rosco-m68k/hardware-projects/mc68681-duart/README.md

# 68681 Dual UART board for rosco_m68k

This directory contains both the XR68C681 DUART board.
