rosco-m68k/hardware-projects/ioread-poc/arduino-ioread/README.md

# Arduino code for IO device demo

See `../README.md` for details
