rosco-m68k/hardware-projects/video9958/code/software/testimage/board.png

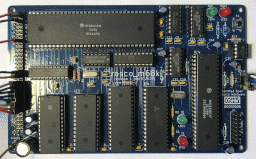
video9958/code/software/testimage/board.png
