rosco-m68k/hardware-projects/video9958/code/software/testimage/boardrender.png

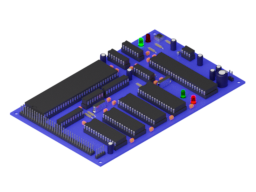
video9958/code/software/testimage/boardrender.png
