rosco-m68k/hardware-projects/(threads)

Thread 7 (2020-05-23):

Bus board mounting holes are the wrong size

roscopeco, 2020-05-23:
The mounting holes on the bus board are the wrong size (M2.5).They should be the same size as the mounting holes on the main board (M3).

The correct footprint for the bus board mounting holes is `MountingHole:MountingHole_3.2mm_M3`.

Closed 2020-05-23.

Thread 8 (2020-05-23):

Screw terminal polarity silkscreen is reversed

roscopeco, 2020-05-23:
The silkscreen indicating polarity of the screw terminals is incorrect and needs to be fixed as a priority.

The polarity is simply reversed.

Closed 2020-05-23.

Thread 18 (2020-07-23):

Pin 14 of the V9958 glue IC needs connecting to DTACK (with a jumper to support r1 boards)

roscopeco, 2020-07-23:
DTACK handling is corrected in r1.2 boards, this now needs to be supported by the V9958 card.

The GAL already does the appropriate thing, but on first revision boards the pin is not connected (an interim jumper wire fix has been issued to the community).

Going forward, this pin needs to be connected. It should run through a jumper to allow the functionality to be disabled when working with an r1 board (driving DTACK on that board will cause excessive current draw and potential incorrect operation).

roscopeco, 2020-08-29:
Fixed on r1.2 (now current).

Closed 2020-08-29.

Thread 26 (2020-09-02):

Use triangular footprint for transistors

roscopeco, 2020-09-02:
The transistors on the various boards (RAM and V9958) should use a triangular footprint, rather than the current in-line footprint which is optimised for automated PnP rather than hand assembly.

(Thanks to Watchmaker for pointing this issue out on Discord)

Thread 45 (2021-07-17):

V9958 Missing Characters on Console

roscopeco, 2021-07-17:
The standard V9958 console in the firmware (reported with both 1.2 and 1.3) occasionally misses characters when printing. This has been reported both as a standalone problem and with other issues (e.g. inability to load software via Kermit of SD card).

A recent occurrence of this issue looked as follows:

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

My current working hypothesis is that we have a race condition somewhere in the console's `PUTCHAR` routine. However, I still cannot rule anything else, including possible hardware issues, out at this point.

Thread 54 (2022-03-16):

Improve "RGB Cut"-label in Xosera schematic

eibach, 2022-03-16:
In the Xosera schematic there is a ``RGB Jumper Cut`` label for the Upduino board. The Upduino silkscreen does not specify an ``RGB`` Jumper, but it is called ``R28``. So please change the label to ``RGB Jumper(R28) Cut``.

roscopeco, 2022-03-16:
Triage: accepted, will do. Thanks @eibach 👍

Thread 56 (2022-11-16):

26.5 lines mode, R#2 bit 7 weirdness

caiannello, 2022-11-16:
Hi,

This is a question rather than an issue. I wanted to try to use the 26.5 lines mode rather than the 24 lines mode, so I added #128 to DM_NTSC (in my case) to ensure bit 7 of R#2 gets set, and changed LINECOUNT from 24 to 26.

I end up with a screen which does indeed have 26.5 lines on it, but the content is all random characters from the chosen font, and I can't seem to be able to change its contents by loading new bytes into VDP text page 0 like I could in 24 line mode.

Do I need to relocate anything in the VRAM such as the pattern table or pattern name tables?  In my current implementation, I have my own VBLANK ISR and I don't even use page 1. I'm always only loading stuff into vdp text page 0. I don't think my problem could be caused by overlap with page 1 since I'm not even using it, but maybe I have to move the font pattern table?

Thanks,
Craig

caiannello, 2022-11-22:
It wasn't a VDP issue, it was a bug.

Closed 2022-11-22.
