rosco-m68k/hardware-projects/xosera/design/kicad/xosera.pdf

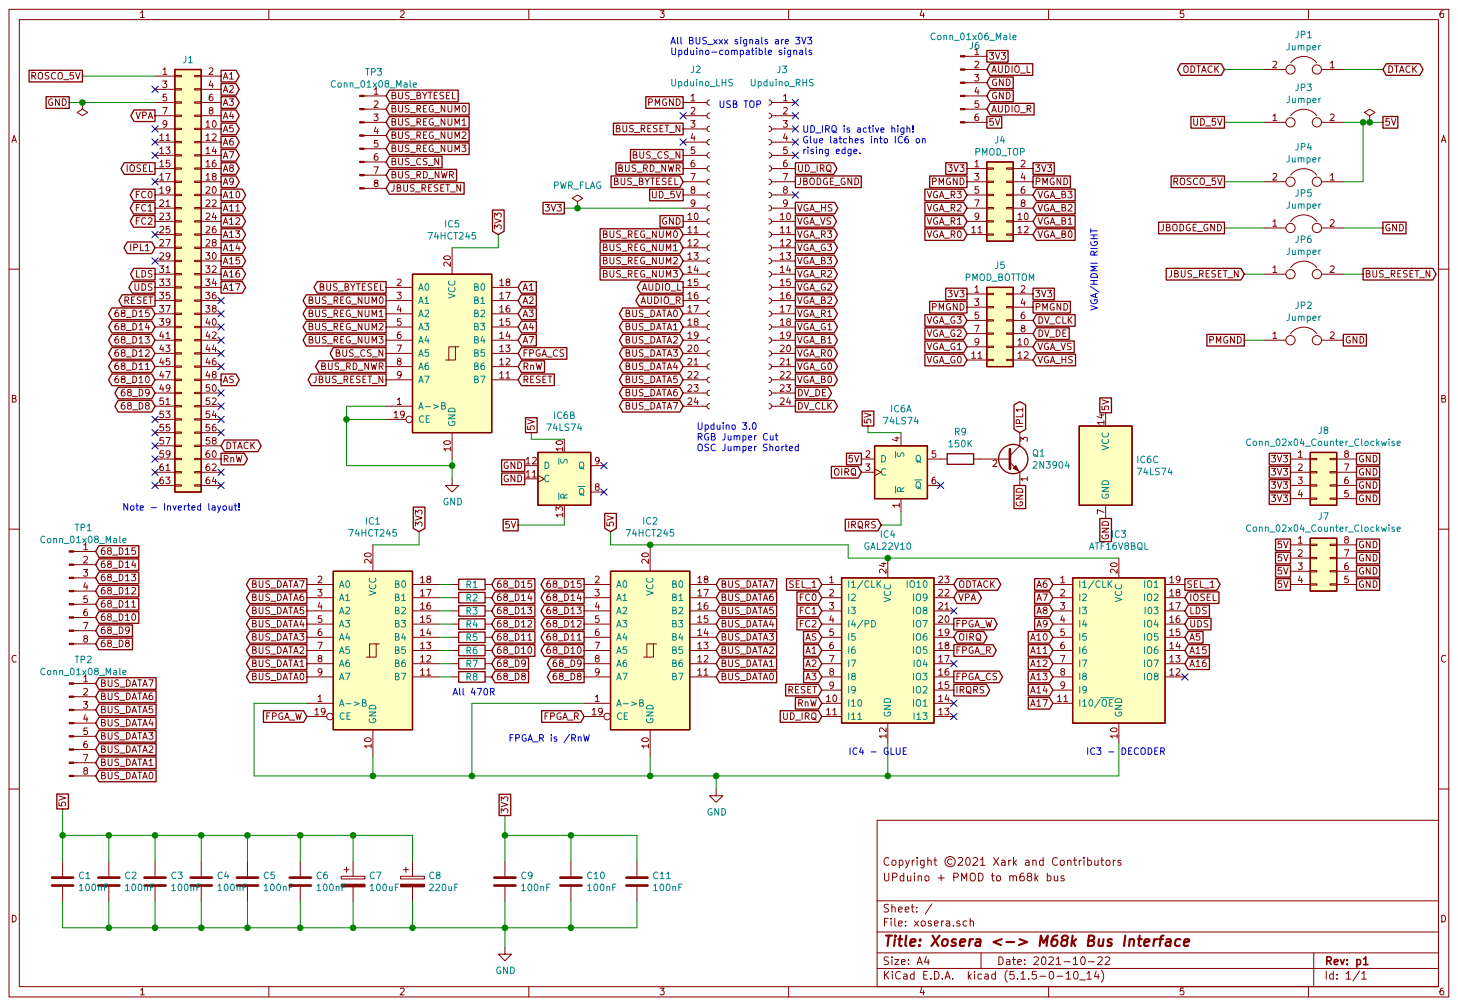
[picture p4: page 1]

File: xosera.sch Sheet: / UPduino + PMOD to m68k bus Copyright ©2021 Xark and Contributors

Id: 1/1 Title: Xosera <-> M68k Bus Interface
