rosco-m68k/hardware-projects/mc68681-duart/design/kicad/mc68681-basic/mc68681-basic.pdf

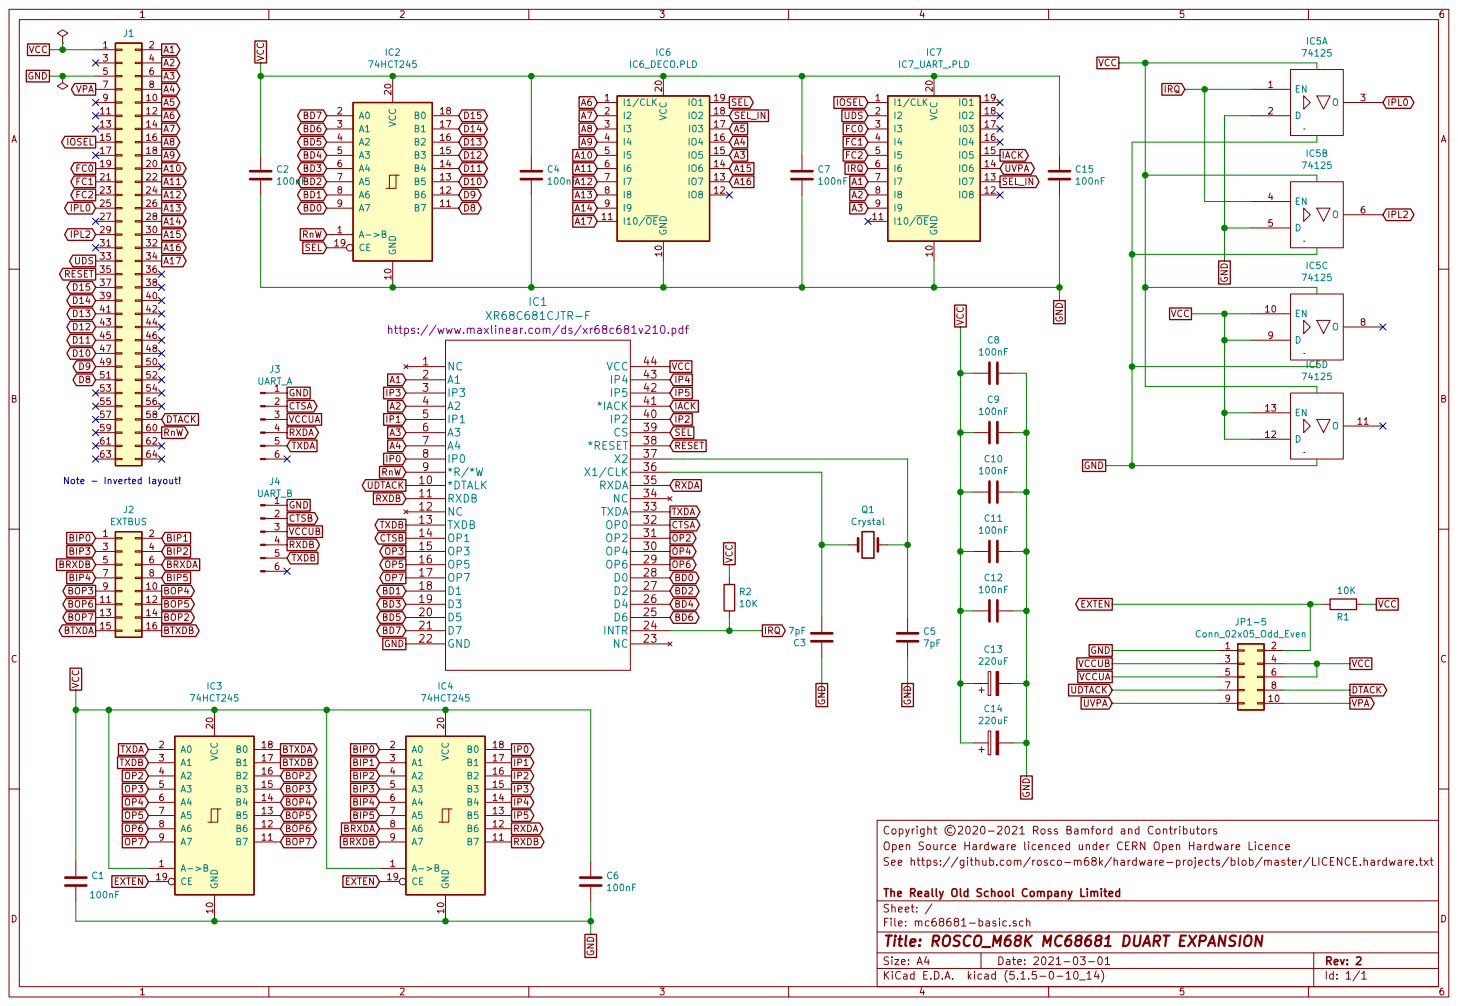
[picture p5: page 1]

TXDA Note - Inverted layout!

Copyright ©2020-2021 Ross Bamford and Contributors
Open Source Hardware licenced under CERN Open Hardware Licence
See https://github.com/rosco-m68k/hardware-projects/blob/master/LICENCE.hardware.txt

File: mc68681-basic.sch Sheet: / The Really Old School Company Limited

Id: 1/1 Title: ROSCO_M68K MC68681 DUART EXPANSION
