rosco-m68k/hardware-projects/flash-rom/design/kicad/flash-rom-expansion/flash-rom-expansion.pdf

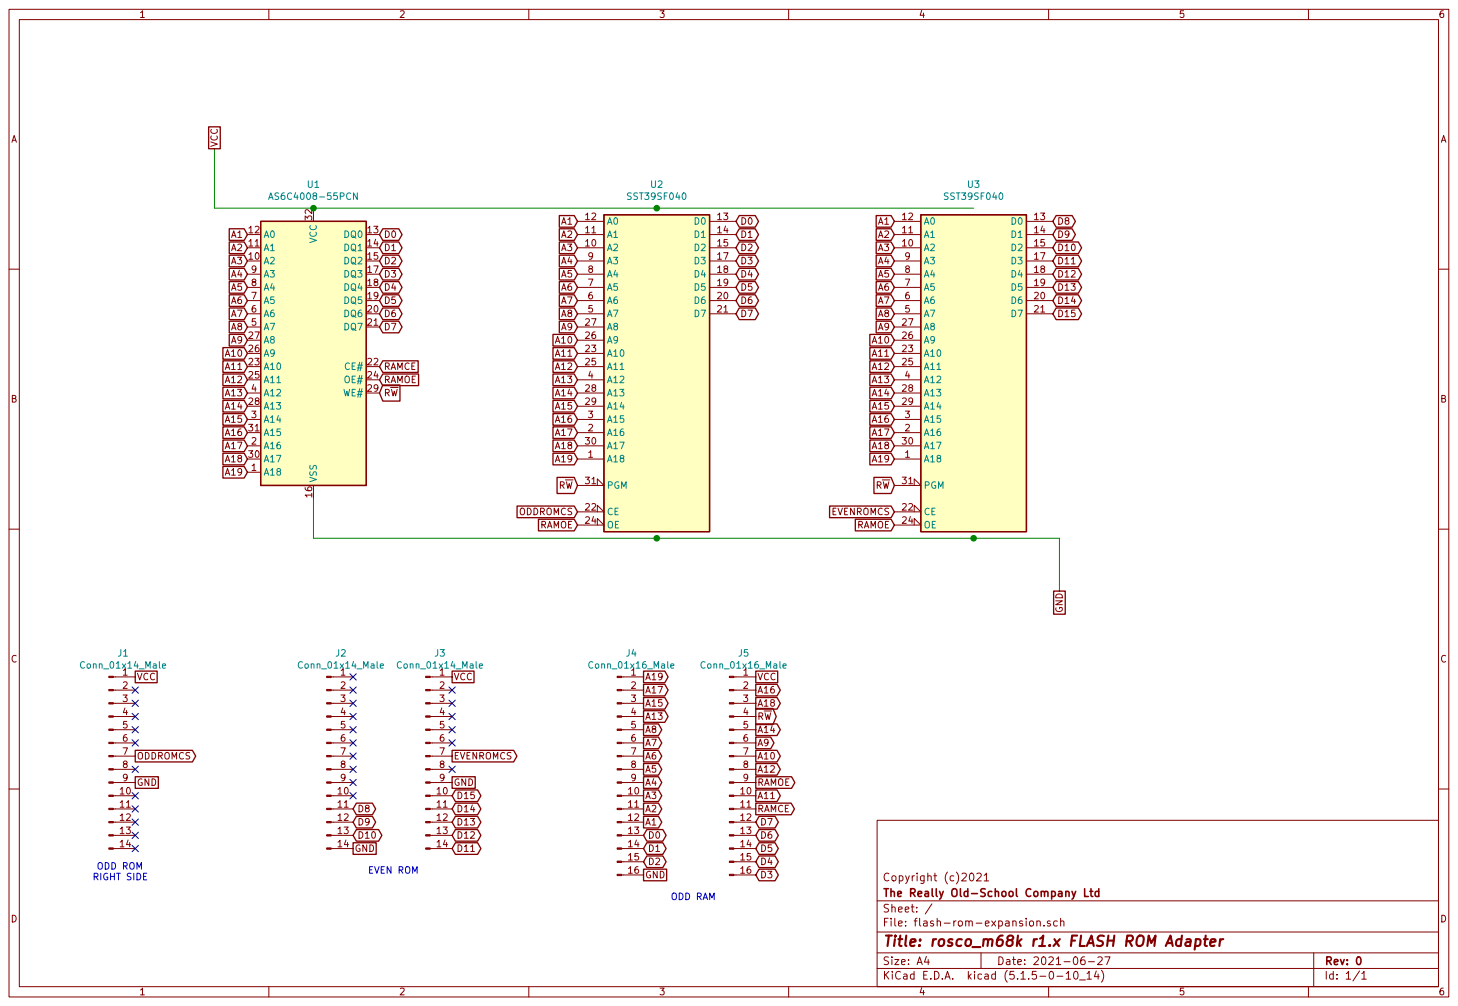
[picture p6: page 1]

EVEN ROM ODD ROM RIGHT SIDE

File: flash-rom-expansion.sch Sheet: / The Really Old-School Company Ltd

Id: 1/1 Title: rosco_m68k r1.x FLASH ROM Adapter
