rosco-m68k/hardware-projects/video9958/design/kicad/v9958video/v9958video.pdf

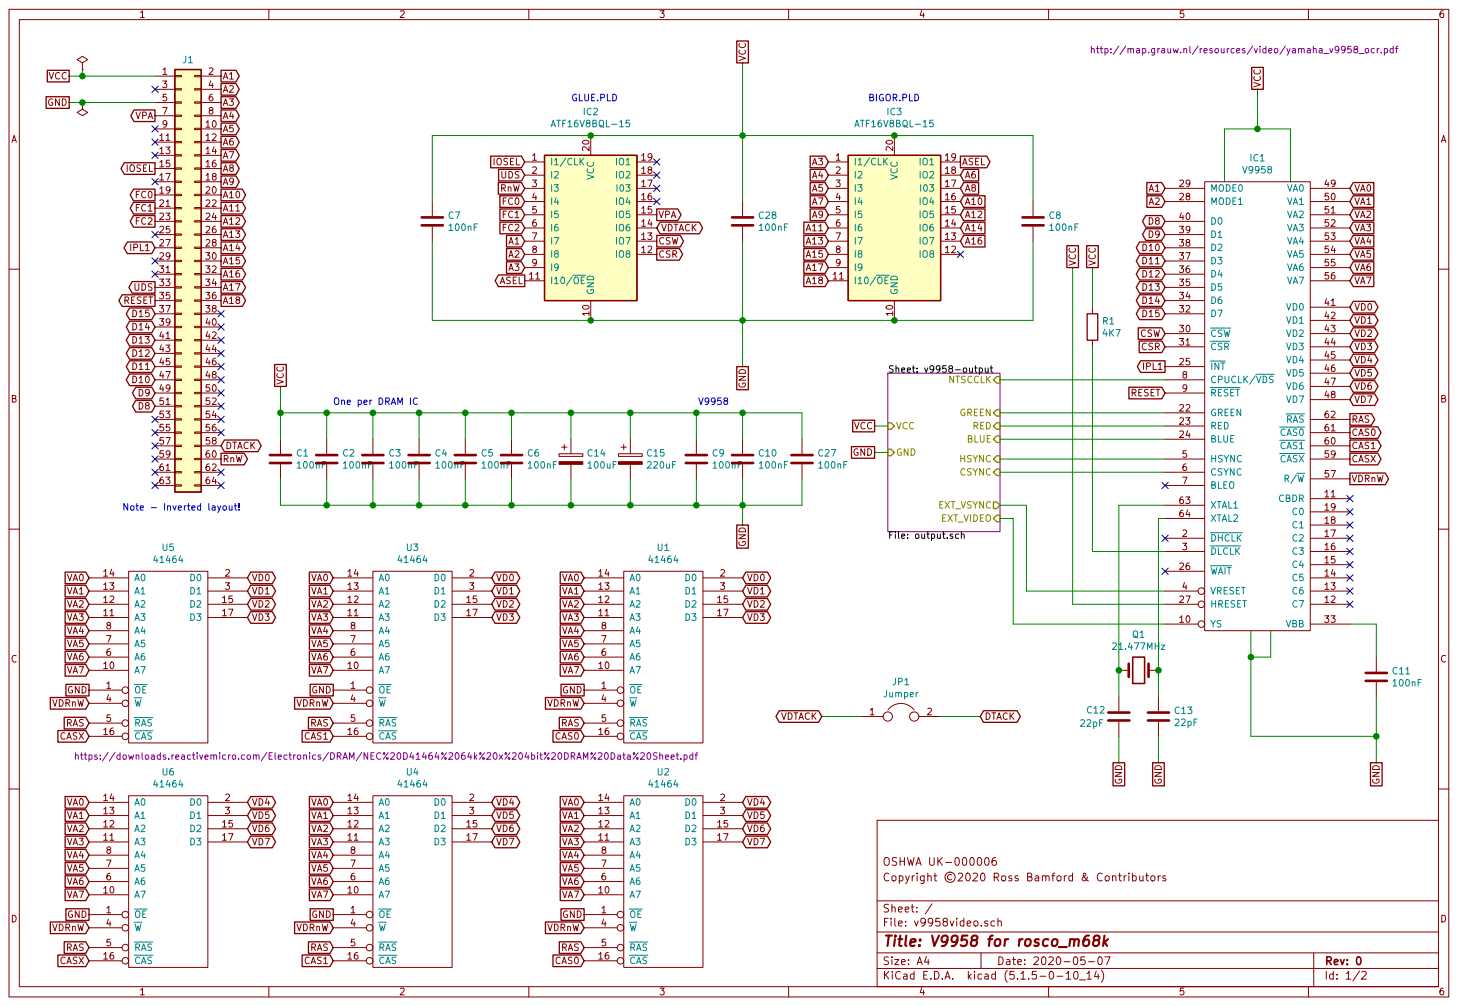
[picture p7: page 1]

File: v9958video.sch Sheet: / Copyright ©2020 Ross Bamford & Contributors OSHWA UK-000006

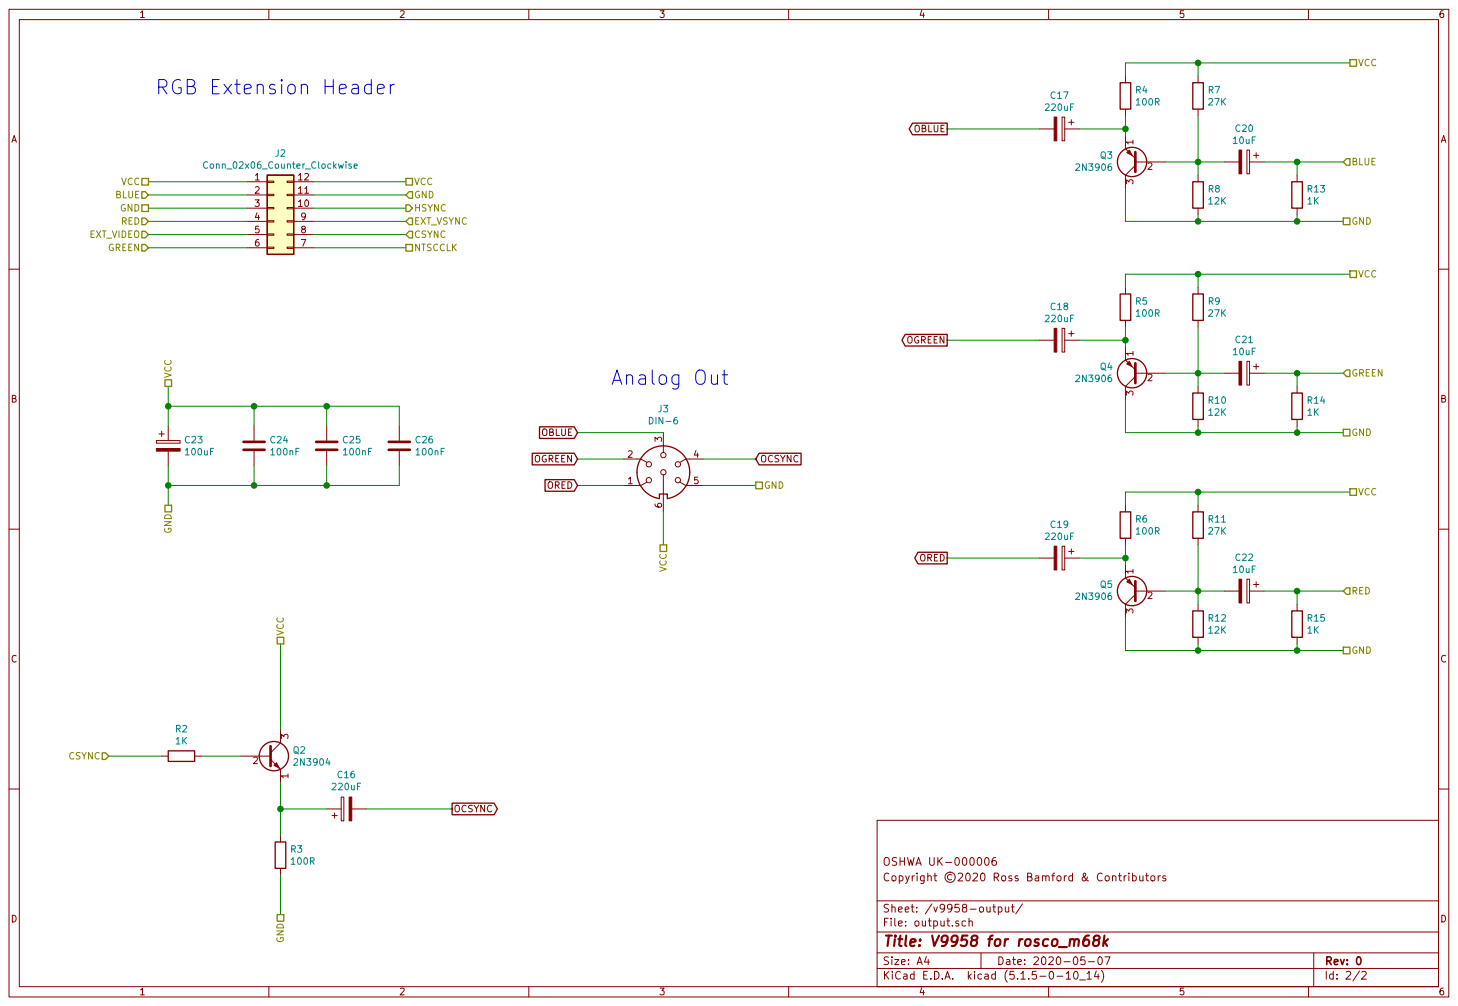
[picture p8: page 2]

Copyright ©2020 Ross Bamford & Contributors OSHWA UK-000006 C26
