rosco-m68k/hardware-projects/bus-board/design/kicad/r0/roscbus01/roscbus01.pdf

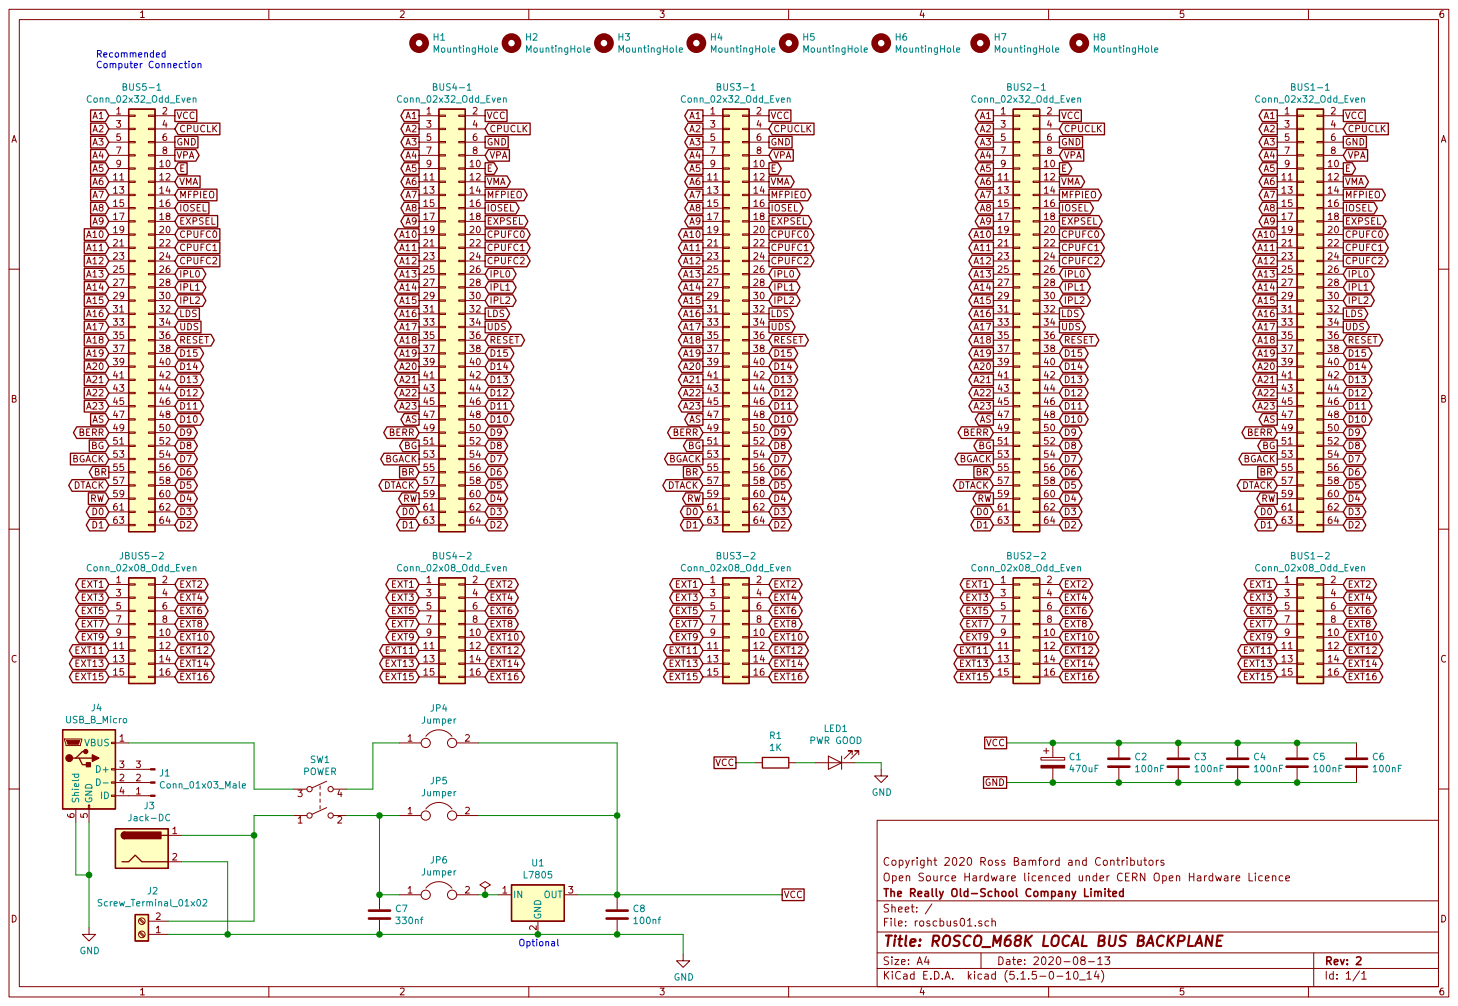
[picture p9: page 1]

Copyright 2020 Ross Bamford and Contributors
Open Source Hardware licenced under CERN Open Hardware Licence
File: roscbus01.sch Sheet: / The Really Old-School Company Limited

Id: 1/1 Title: ROSCO_M68K LOCAL BUS BACKPLANE
