rosco-m68k/hardware-projects/(list of files, drawings)

Other design files:
RAM-hat-4MB/Rosco_Hat_RAM.dsn
