rosco-m68k/hardware-projects/(commit log)

2020-04-13 Ignore kicad backups
2020-04-13 First cut od RAM expansion
    [roscram01.kicad_pcb, roscram01.sch]
2020-04-15 First cut for manufacturing
    [roscram01-B_Cu.gbr, roscram01-B_Mask.gbr, roscram01-B_Paste.gbr, roscram01-B_SilkS.gbr, roscram01-Edge_Cuts.gbr, roscram01-F_Cu.gbr, roscram01-F_Mask.gbr, roscram01-F_Paste.gbr]
2020-04-20 Add board image
2020-04-25 First cut bus board
    [roscbus01.kicad_pcb, roscbus01.sch]
2020-04-25 Updates and add CAM outputs
    [roscbus01-B_Cu.gbr, roscbus01-B_Mask.gbr, roscbus01-B_Paste.gbr, roscbus01-B_SilkS.gbr, roscbus01-Edge_Cuts.gbr, roscbus01-F_Cu.gbr, roscbus01-F_Mask.gbr, roscbus01-F_Paste.gbr]
2020-04-29 Fix incorrect size and clean up
    [roscram01-B_Cu.gbr, roscram01-B_Mask.gbr, roscram01-B_Paste.gbr, roscram01-B_SilkS.gbr, roscram01-Edge_Cuts.gbr, roscram01-F_Cu.gbr, roscram01-F_Mask.gbr, roscram01-F_Paste.gbr]
2020-05-07 Silkscreen fixes
    [roscbus01.kicad_pcb]
2020-05-08 Minor fixes
    [roscbus01-B_Cu.gbr, roscbus01-B_Mask.gbr, roscbus01-B_Paste.gbr, roscbus01-B_SilkS.gbr, roscbus01-Edge_Cuts.gbr, roscbus01-F_Cu.gbr, roscbus01-F_Mask.gbr, roscbus01-F_Paste.gbr]
2020-05-14 Add RAM expension BOM
    [roscram01.csv]
2020-05-14 First cut video board and supporting code
    [output.sch, v9958video.kicad_pcb, v9958video.sch]
2020-05-14 First cut PCB
    [output.sch, v9958video.kicad_pcb, v9958video.sch]
2020-05-23 First round fixes
    [output.sch, v9958video.kicad_pcb, v9958video.sch]
2020-05-23 Add BOM
    [roscbus01.csv, roscbus01.sch]
2020-05-23 Rev 1 - Four layer board
    [output.sch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]
2020-05-23 Add missed changes from CAM output
    [v9958video.kicad_pcb]
2020-05-23 Fix #8
    [roscbus01.kicad_pcb]
2020-05-23 Fix #7
    [roscbus01-B_Cu.gbr, roscbus01-B_Mask.gbr, roscbus01-B_Paste.gbr, roscbus01-B_SilkS.gbr, roscbus01-Edge_Cuts.gbr, roscbus01-F_Cu.gbr, roscbus01-F_Mask.gbr, roscbus01-F_Paste.gbr]
2020-06-03 Make IC numbering less nonsensical
    [v9958video.kicad_pcb, v9958video.sch]
2020-06-05 Revision 1.1 RTM
    [output.sch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]
2020-06-05 Final tweaks
    [v9958video-B_Cu.gbr, v9958video-B_Mask.gbr, v9958video-B_Paste.gbr, v9958video-B_SilkS.gbr, v9958video-Edge_Cuts.gbr, v9958video-F_Cu.gbr, v9958video-F_Mask.gbr, v9958video-F_Paste.gbr]
2020-06-07 Initial work
    [mc68681-basic.kicad_pcb, mc68681-basic.sch]
2020-06-12 r0 layout, PLD changes for same
    [mc68681-basic-B_Cu.gbr, mc68681-basic-B_Mask.gbr, mc68681-basic-B_Paste.gbr, mc68681-basic-B_SilkS.gbr, mc68681-basic-Edge_Cuts.gbr, mc68681-basic-F_Cu.gbr, mc68681-basic-F_Mask.gbr, mc68681-basic-F_Paste.gbr]
2020-06-12 List DUART board in README
2020-06-16 First-cut console
2020-06-25 Fix a couple of issues...
    [mc68681-basic-B_Cu.gbr, mc68681-basic-B_Mask.gbr, mc68681-basic-B_Paste.gbr, mc68681-basic-B_SilkS.gbr, mc68681-basic-Edge_Cuts.gbr, mc68681-basic-F_Cu.gbr, mc68681-basic-F_Mask.gbr, mc68681-basic-F_Paste.gbr]
2020-07-02 Final version RTM
    [mc68681-basic-B_Cu.gbr, mc68681-basic-B_Mask.gbr, mc68681-basic-B_Paste.gbr, mc68681-basic-B_SilkS.gbr, mc68681-basic-Edge_Cuts.gbr, mc68681-basic-F_Cu.gbr, mc68681-basic-F_Mask.gbr, mc68681-basic-F_Paste.gbr]
2020-07-20 Add first-cut memory map
2020-08-13 Bus revision 3
    [roscbus01-B_Cu.gbr, roscbus01-B_Mask.gbr, roscbus01-B_Paste.gbr, roscbus01-B_SilkS.gbr, roscbus01-Edge_Cuts.gbr, roscbus01-F_Cu.gbr, roscbus01-F_Mask.gbr, roscbus01-F_Paste.gbr]
2020-08-13 VDP r1.2
    [v9958video-B_Cu.gbr, v9958video-B_Mask.gbr, v9958video-B_Paste.gbr, v9958video-B_SilkS.gbr, v9958video-Edge_Cuts.gbr, v9958video-F_Cu.gbr, v9958video-F_Mask.gbr, v9958video-F_Paste.gbr]
2020-08-13 Add jumper to support 1.2 mainboard
    [v9958video-B_Cu.gbr, v9958video-B_Mask.gbr, v9958video-B_Paste.gbr, v9958video-B_SilkS.gbr, v9958video-Edge_Cuts.gbr, v9958video-F_Cu.gbr, v9958video-F_Mask.gbr, v9958video-F_Paste.gbr]
2020-08-13 Add missed change
    [v9958video.kicad_pcb]
2020-08-29 Fix incorrect direction for EXT drivers
    [mc68681-basic-B_Cu.gbr, mc68681-basic-B_Mask.gbr, mc68681-basic-B_Paste.gbr, mc68681-basic-B_SilkS.gbr, mc68681-basic-Edge_Cuts.gbr, mc68681-basic-F_Cu.gbr, mc68681-basic-F_Mask.gbr, mc68681-basic-F_Paste.gbr]
2020-09-16 Fixes for 1.2 mainboard
    [mc68681-basic-B_Cu.gbr, mc68681-basic-B_Mask.gbr, mc68681-basic-B_Paste.gbr, mc68681-basic-B_SilkS.gbr, mc68681-basic-Edge_Cuts.gbr, mc68681-basic-F_Cu.gbr, mc68681-basic-F_Mask.gbr, mc68681-basic-F_Paste.gbr]
2021-03-21 Claim IPL3 and 00F80040-00F8005F for my ATA/IDE board.
2021-03-21 Correct type of interrupt used by MC68681 cards.
2021-04-06 Add new XR68C681 board
    [mc68681-basic-B_Cu.gbr, mc68681-basic-B_Mask.gbr, mc68681-basic-B_Paste.gbr, mc68681-basic-B_SilkS.gbr, mc68681-basic-Edge_Cuts.gbr, mc68681-basic-F_Cu.gbr, mc68681-basic-F_Mask.gbr, mc68681-basic-F_Paste.gbr]
2021-06-26 Add 020/030 etc to libs
    [rosco_m68k_r1_020.csv]
2021-06-26 DUART 2.1
    [mc68681-basic-B_Cu.gbr, mc68681-basic-B_Mask.gbr, mc68681-basic-B_Paste.gbr, mc68681-basic-B_SilkS.gbr, mc68681-basic-Edge_Cuts.gbr, mc68681-basic-F_Cu.gbr, mc68681-basic-F_Mask.gbr, mc68681-basic-F_Paste.gbr]
2021-06-27 First cut flash ROM adapter
    [flash-rom-expansion-B_Cu.gbr, flash-rom-expansion-B_Mask.gbr, flash-rom-expansion-B_Paste.gbr, flash-rom-expansion-B_SilkS.gbr, flash-rom-expansion-Edge_Cuts.gbr, flash-rom-expansion-F_Cu.gbr, flash-rom-expansion-F_Mask.gbr, flash-rom-expansion-F_Paste.gbr]
2021-06-27 Fix unconnected A16 (thanks to JLCPCB for spotting)
    [flash-rom-expansion-B_Cu.gbr, flash-rom-expansion-B_Mask.gbr, flash-rom-expansion-B_Paste.gbr, flash-rom-expansion-B_SilkS.gbr, flash-rom-expansion-Edge_Cuts.gbr, flash-rom-expansion-F_Cu.gbr, flash-rom-expansion-F_Mask.gbr, flash-rom-expansion-F_Paste.gbr]
2021-07-07 Add initial Xosera design and GAL code
    [output.sch, xosera.kicad_pcb, xosera.sch]
2021-07-07 Update schematic for new glue and buffer
    [xosera.sch]
2021-07-07 Flesh out schematic, ERC pass and prep for layout
    [xosera.sch]
2021-07-07 Add extra GND jumper, audio, start PCB placement
    [xosera.kicad_pcb, xosera.sch]
2021-07-07 Move reset pin
    [xosera.sch]
2021-07-07 Rejig pins, fix names and change buffer pinouts
    [xosera.sch]
2021-07-07 Switch HDMI_CLK to DV_CLK
    [xosera.sch]
2021-07-07 Add testpoints and change net names a bit to match Xark's Verilog
    [xosera.sch]
2021-07-07 Also rename DVI_EN to DV_EN for consistency
    [xosera.sch]
2021-07-07 Switch DV_EN for DV_DE for 1BitSquared consistency
    [xosera.sch]
2021-07-07 First cut add software tests
2021-07-07 Layout PCB
    [xosera-B_Cu.gbr, xosera-B_Mask.gbr, xosera-B_Paste.gbr, xosera-B_SilkS.gbr, xosera-Edge_Cuts.gbr, xosera-F_Cu.gbr, xosera-F_Mask.gbr, xosera-F_Paste.gbr]
2021-07-07 First cut new GAL and IACK
    [xosera.kicad_pcb, xosera.sch]
2021-07-07 Proto r1
    * IRQ / IACK support
    * Fixed PMOD layout
    [xosera-B_Cu.gbr, xosera-B_Mask.gbr, xosera-B_Paste.gbr, xosera-B_SilkS.gbr, xosera-Edge_Cuts.gbr, xosera-F_Cu.gbr, xosera-F_Mask.gbr, xosera-F_Paste.gbr]
2021-07-07 Further fixes for r1
    * Add RESET jumper
    * Fix 7474 hookup
    [xosera-B_Cu.gbr, xosera-B_Mask.gbr, xosera-B_Paste.gbr, xosera-B_SilkS.gbr, xosera-Edge_Cuts.gbr, xosera-F_Cu.gbr, xosera-F_Mask.gbr, xosera-F_Paste.gbr]
2021-07-07 Add GPIO10 and 3V3 on audio header
    [xosera-B_Cu.gbr, xosera-B_Mask.gbr, xosera-B_Paste.gbr, xosera-B_SilkS.gbr, xosera-Edge_Cuts.gbr, xosera-F_Cu.gbr, xosera-F_Mask.gbr, xosera-F_Paste.gbr]
2021-07-11 Revert "DUART 2.1"
    This reverts commit 27795c8f7bdad45632c07cace90e5a666905ce82.
    [mc68681-basic-B_Cu.gbr, mc68681-basic-B_Mask.gbr, mc68681-basic-B_Paste.gbr, mc68681-basic-B_SilkS.gbr, mc68681-basic-Edge_Cuts.gbr, mc68681-basic-F_Cu.gbr, mc68681-basic-F_Mask.gbr, mc68681-basic-F_Paste.gbr]
2021-08-12 Fix IRQ reset / acknowledge glue
2021-08-12 Update IRQ test to print one asterisk per second
2021-08-13 Update for GPIO10 IRQ
    [xosera-B_Cu.gbr, xosera-B_Mask.gbr, xosera-B_Paste.gbr, xosera-B_SilkS.gbr, xosera-Edge_Cuts.gbr, xosera-F_Cu.gbr, xosera-F_Mask.gbr, xosera-F_Paste.gbr]
2021-08-15 Add automatic end-of-interrupt
    With this change, the glue logic will automatically clear the
    interrupt latch, meaning software will no longer need to do
    a Xosera read to clear it.
    In discussion on Discord this was felt to be more useful, and
    neatly sidesteps a few issues when a non-Xosera specific handler
    is registered (i.e. if level 2 interrupts are enabled without
    a handler other than the basic one provided by the firmware).
    It also makes races less likely when multiple interrupts overlap
    (e.g. another is raised while one is still in-service).
2021-08-15 Add missing footprints / update logo
2021-08-15 Preparing for production...
    [xosera-B_Cu.gbr, xosera-B_Mask.gbr, xosera-B_Paste.gbr, xosera-B_SilkS.gbr, xosera-Edge_Cuts.gbr, xosera-F_Cu.gbr, xosera-F_Mask.gbr, xosera-F_Paste.gbr]
2021-08-15 Remove J9
    [xosera-B_Cu.gbr, xosera-B_Mask.gbr, xosera-B_Paste.gbr, xosera-B_SilkS.gbr, xosera-Edge_Cuts.gbr, xosera-F_Cu.gbr, xosera-F_Mask.gbr, xosera-F_Paste.gbr]
2021-08-15 Remove no-longer-needed software interrupt ack
2021-08-25 Tidy up
    [xosera.kicad_pcb]
2021-10-05 Fixed gerbers for 68681
    [mc68681-basic-B_Cu.gbr, mc68681-basic-B_Mask.gbr, mc68681-basic-B_Paste.gbr, mc68681-basic-B_SilkS.gbr, mc68681-basic-Edge_Cuts.gbr, mc68681-basic-F_Cu.gbr, mc68681-basic-F_Mask.gbr, mc68681-basic-F_Paste.gbr]
2021-10-05 Add replaced gerber zip
2021-10-05 Revert "Add replaced gerber zip"
    This reverts commit ec4685204fd3dedd05f2adf4224ef164f58c7c3a.
2021-10-05 Add Xosera prod r0
    [xosera-B_Cu.gbr, xosera-B_Mask.gbr, xosera-B_Paste.gbr, xosera-B_SilkS.gbr, xosera-Edge_Cuts.gbr, xosera-F_Cu.gbr, xosera-F_Mask.gbr, xosera-F_Paste.gbr]
2021-10-05 Add updated gerbers for 68681
2021-10-20 Remove obsolete 16V8 glue
2021-10-20 Fix incorrect DUART gerbers
    [mc68681-basic-B_Cu.gbr, mc68681-basic-B_Mask.gbr, mc68681-basic-B_Paste.gbr, mc68681-basic-B_SilkS.gbr, mc68681-basic-Edge_Cuts.gbr, mc68681-basic-F_Cu.gbr, mc68681-basic-F_Mask.gbr, mc68681-basic-F_Paste.gbr]
2021-10-20 Remove abandoned extended DUART
    [mc68681-basic-B_Cu.gbr, mc68681-basic-B_Mask.gbr, mc68681-basic-B_Paste.gbr, mc68681-basic-B_SilkS.gbr, mc68681-basic-Edge_Cuts.gbr, mc68681-basic-F_Cu.gbr, mc68681-basic-F_Mask.gbr, mc68681-basic-F_Paste.gbr]
2021-10-22 Add RESET to glue and tidy up
2021-10-22 Update layout for new glue
    [xosera.kicad_pcb, xosera.sch]
2021-10-22 Remove obsolete gerbers/drills
    [xosera-B_Cu.gbr, xosera-B_Mask.gbr, xosera-B_Paste.gbr, xosera-B_SilkS.gbr, xosera-Edge_Cuts.gbr, xosera-F_Cu.gbr, xosera-F_Mask.gbr, xosera-F_Paste.gbr]
2021-10-23 p1 layout
    [xosera-B_Cu.gbr, xosera-B_Mask.gbr, xosera-B_Paste.gbr, xosera-B_SilkS.gbr, xosera-Edge_Cuts.gbr, xosera-F_Cu.gbr, xosera-F_Mask.gbr, xosera-F_Paste.gbr]
2021-10-30 Fix minor issues and redo PDF
    [xosera.kicad_pcb]
2021-10-30 p1 production
    [xosera-B_Cu.gbr, xosera-B_Mask.gbr, xosera-B_Paste.gbr, xosera-B_SilkS.gbr, xosera-Edge_Cuts.gbr, xosera-F_Cu.gbr, xosera-F_Mask.gbr, xosera-F_Paste.gbr]
2021-10-30 Remove obsolete duart CAM data
    [mc68681-basic-B_Cu.gbr, mc68681-basic-B_Mask.gbr, mc68681-basic-B_Paste.gbr, mc68681-basic-B_SilkS.gbr, mc68681-basic-Edge_Cuts.gbr, mc68681-basic-F_Cu.gbr, mc68681-basic-F_Mask.gbr, mc68681-basic-F_Paste.gbr]
2021-10-30 Add updated CAM data and new PDF
    [mc68681-basic-B_Cu.gbr, mc68681-basic-B_Mask.gbr, mc68681-basic-B_Paste.gbr, mc68681-basic-B_SilkS.gbr, mc68681-basic-Edge_Cuts.gbr, mc68681-basic-F_Cu.gbr, mc68681-basic-F_Mask.gbr, mc68681-basic-F_Paste.gbr]
2022-09-18 Add HeathenUK's 4MB SRAM Hat
    [BOM-Rosco_Hat.csv, BOM-Rosco_Hat_RAM.csv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]
