rosco-m68k/hardware-projects/(notices)

Notices in the files:
ram-expansion/design/kicad/roscram01.sch:
Open-Source Hardware licenced under the CERN Open Hardware Licence
Copyright ©2020 Ross Bamford and Contributors
flash-rom/design/kicad/flash-rom-expansion/flash-rom-expansion.sch:
Copyright (c)2021
xosera/design/kicad/xosera.kicad_pcb:
© Xark & Contributors
mc68681-duart/mc68681-duart-basic/design/kicad/mc68681-basic/mc68681-basic.kicad_pcb:
Copyright ©2021 Ross Bamford & Contributors
